AriM25/FPGARobot/ImagineRobot.jpeg

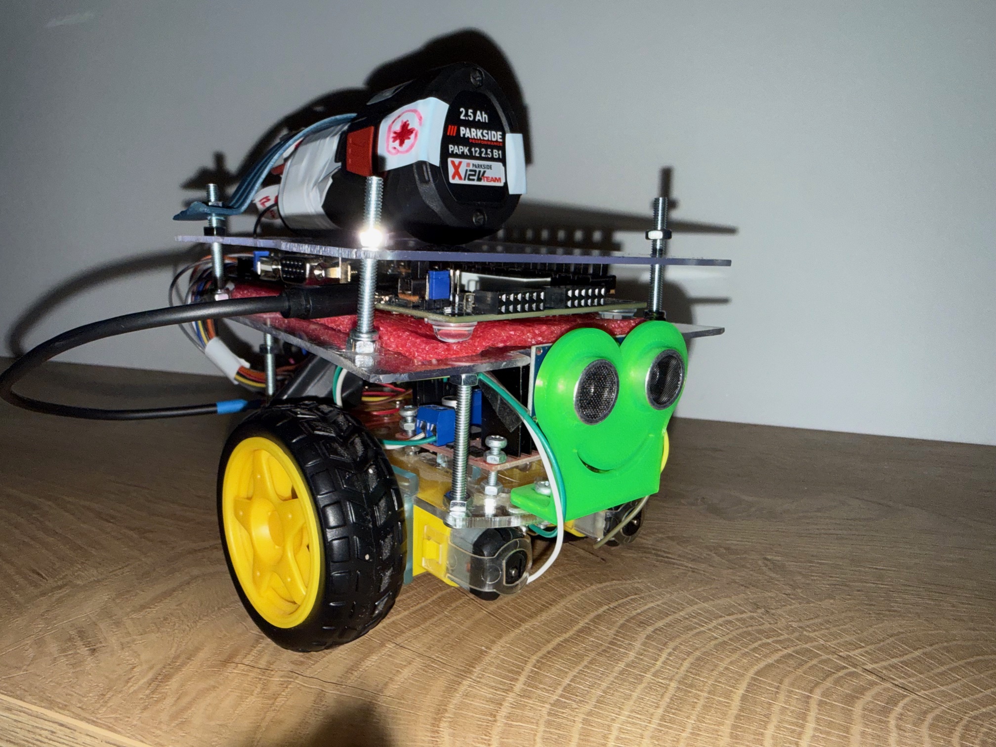
ImagineRobot.jpeg
