AriM25/FPGARobot/doc/schema_robot.png

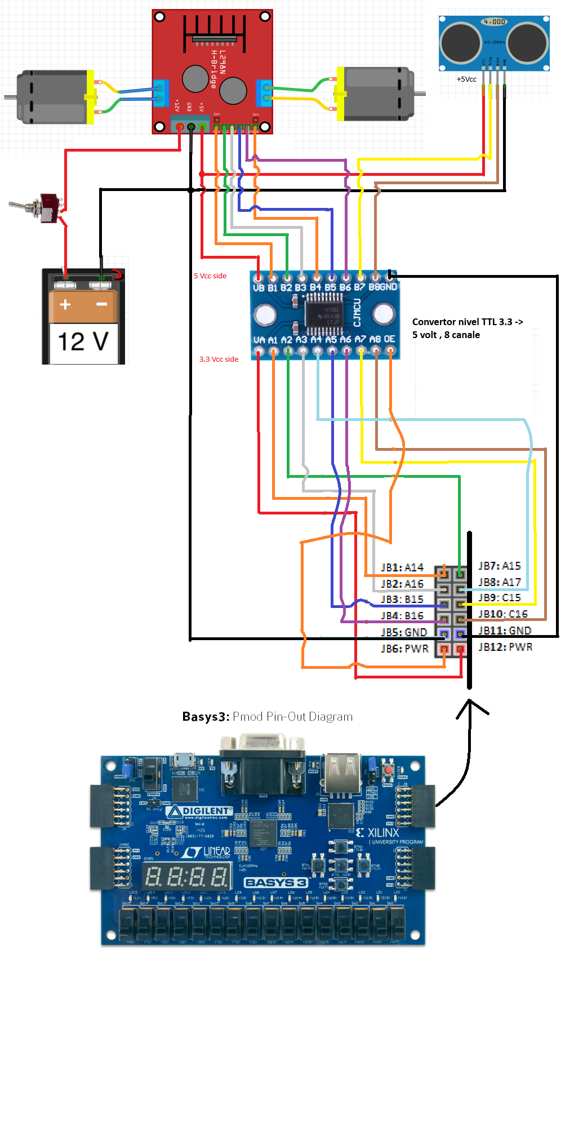
doc/schema_robot.png
