AriM25/FPGARobot/project_3.runs/impl_1/.init_design.begin.rst

<?xml version="1.0"?>
<ProcessHandle Version="1" Minor="0">
    <Process Command=".planAhead." Owner="user" Host="DESKTOP-JF7BU5U" Pid="18220">
    </Process>
</ProcessHandle>
