AriM25/FPGARobot/project_3.runs/impl_1/.vivado.begin.rst

<?xml version="1.0"?>
<ProcessHandle Version="1" Minor="0">
    <Process Command="vivado.bat" Owner="user" Host="DESKTOP-JF7BU5U" Pid="25884" HostCore="8" HostMemory="034245660672">
    </Process>
</ProcessHandle>
