AriM25/FPGARobot/project_3.runs/synth_1/.Xil/robot_propImpl.xdc

set_property SRC_FILE_INFO {cfile:C:/Users/user/Documents/FPGA/project_3/project_3.srcs/constrs_1/new/constrains.xdc rfile:../../../project_3.srcs/constrs_1/new/constrains.xdc id:1} [current_design]
set_property src_info {type:XDC file:1 line:2 export:INPUT save:INPUT read:READ} [current_design]
set_property PACKAGE_PIN L1 [get_ports led]
set_property src_info {type:XDC file:1 line:5 export:INPUT save:INPUT read:READ} [current_design]
set_property PACKAGE_PIN C15 [get_ports trigger]
set_property src_info {type:XDC file:1 line:9 export:INPUT save:INPUT read:READ} [current_design]
set_property PACKAGE_PIN W5 [get_ports fpgaclk]
set_property src_info {type:XDC file:1 line:12 export:INPUT save:INPUT read:READ} [current_design]
set_property PACKAGE_PIN A14 [get_ports Motor_L_pwm]
set_property src_info {type:XDC file:1 line:13 export:INPUT save:INPUT read:READ} [current_design]
set_property PACKAGE_PIN A15 [get_ports Motor_L_in_1]
set_property src_info {type:XDC file:1 line:14 export:INPUT save:INPUT read:READ} [current_design]
set_property PACKAGE_PIN A16 [get_ports Motor_L_in_2]
set_property src_info {type:XDC file:1 line:18 export:INPUT save:INPUT read:READ} [current_design]
set_property PACKAGE_PIN A17 [get_ports Motor_R_pwm]
set_property src_info {type:XDC file:1 line:21 export:INPUT save:INPUT read:READ} [current_design]
set_property PACKAGE_PIN B16 [get_ports Motor_R_in_4]
set_property src_info {type:XDC file:1 line:24 export:INPUT save:INPUT read:READ} [current_design]
set_property PACKAGE_PIN B15 [get_ports Motor_R_in_3]
set_property src_info {type:XDC file:1 line:26 export:INPUT save:INPUT read:READ} [current_design]
set_property PACKAGE_PIN C16 [get_ports echo]
