AriM25/FPGARobot/project_3.srcs/sources_1/imports/FPGA_Robot/clkdiv.vhd

LIBRARY ieee;
USE ieee.std_logic_1164.ALL;
USE ieee.std_logic_unsigned.ALL;

ENTITY clkdiv IS
    PORT (
        clock_50 : IN std_logic;
        clr : IN std_logic;
        clock_q : OUT std_logic);
END ENTITY;

ARCHITECTURE behaviour OF clkdiv is
    SIGNAL q : std_logic_vector(23 DOWNTO 0);
BEGIN
    --clock divider
    PROCESS (clock_50, clr)
    BEGIN
        IF clr = '1' THEN
            q <= X"000000"; -- hex number
        ELSIF clock_50'event AND clock_50 = '1' THEN
            q <= q + 1;
        END IF;
    END PROCESS;
    clock_q <= q(6);
END ARCHITECTURE;
